benediktibk/electronics-library/3d-models/TS04-66-73-BK-100-SMT.stp

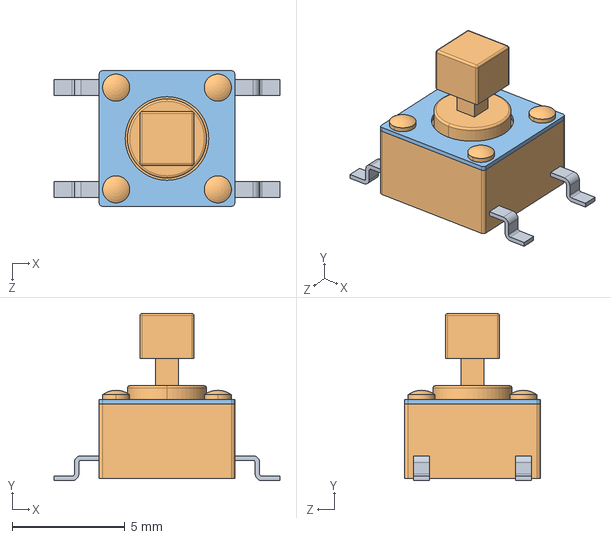
[picture p1: CAD file, 2025-07-14]
3d-models/TS04-66-73-BK-100-SMT.stp
10.0 x 7.40 x 6.00 mm
