benediktibk/electronics-library/3d-models/AT24C512C-SSHM-T.stp

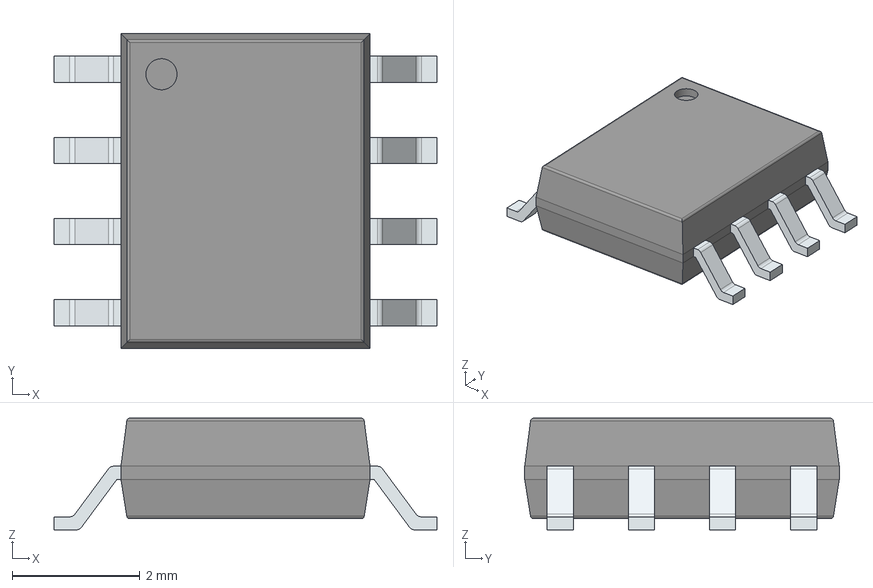
[picture p2: CAD file, 2025-07-14]
3d-models/AT24C512C-SSHM-T.stp
6.00 x 4.92 x 1.75 mm
PinsArrayLR
