benediktibk/electronics-library/3d-models/SRN2012T-6R8K.stp

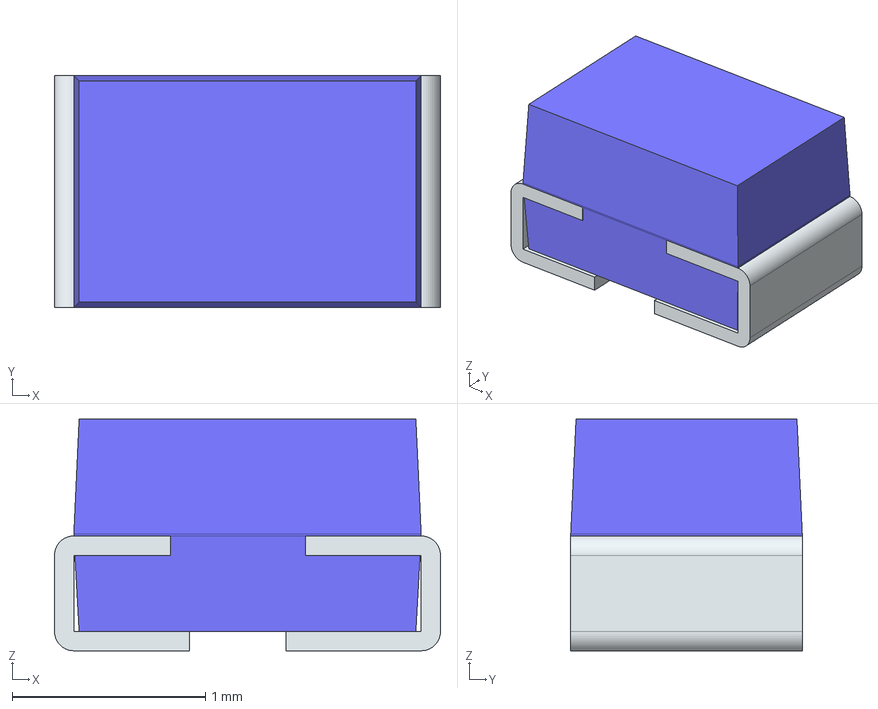
[picture p3: CAD file, 2025-07-11]
3d-models/SRN2012T-6R8K.stp
2.00 x 1.20 x 1.20 mm
FilletPin1
FilletPin2
