benediktibk/electronics-library/3d-models/LAN8720A-CP-ABC.stp

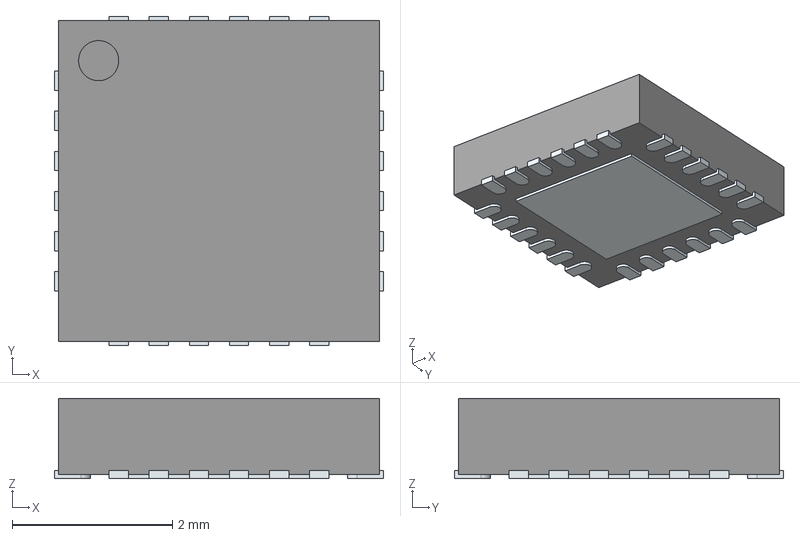
[picture p4: CAD file, 2025-07-11]
3d-models/LAN8720A-CP-ABC.stp
4.10 x 4.10 x 1.00 mm
ThermalPin
PinsArrayLR
PinsArrayTB
