benediktibk/electronics-library/3d-models/SDR0503-102KL.stp

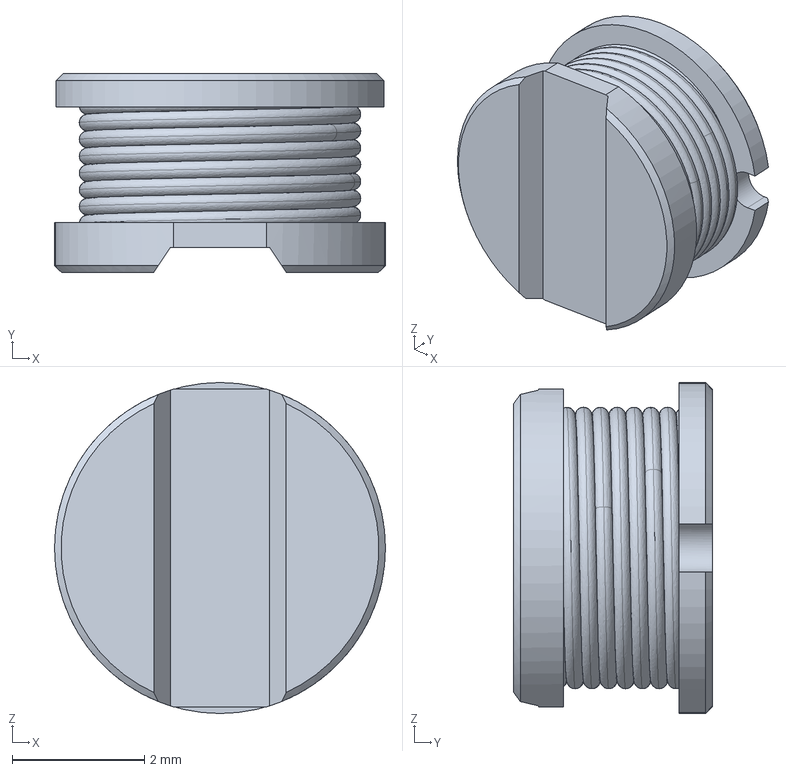
[picture p5: CAD file, 2025-07-11]
3d-models/SDR0503-102KL.stp
5.00 x 3.00 x 5.00 mm
