benediktibk/electronics-library/3d-models/B280-13-F.stp

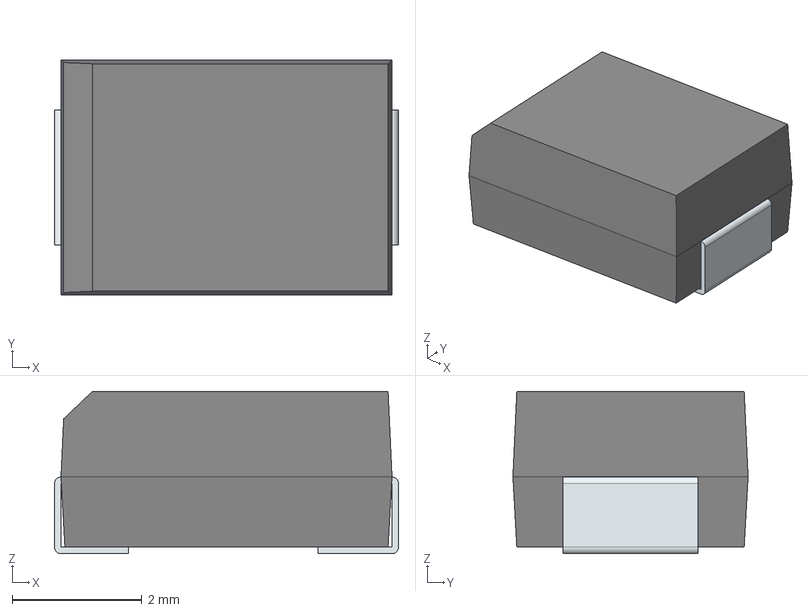
[picture p6: CAD file, 2025-07-11]
3d-models/B280-13-F.stp
5.29 x 3.62 x 2.50 mm
FilletPin1
FilletPin2
