benediktibk/electronics-library/3d-models/LV2862XLVDDCR.stp

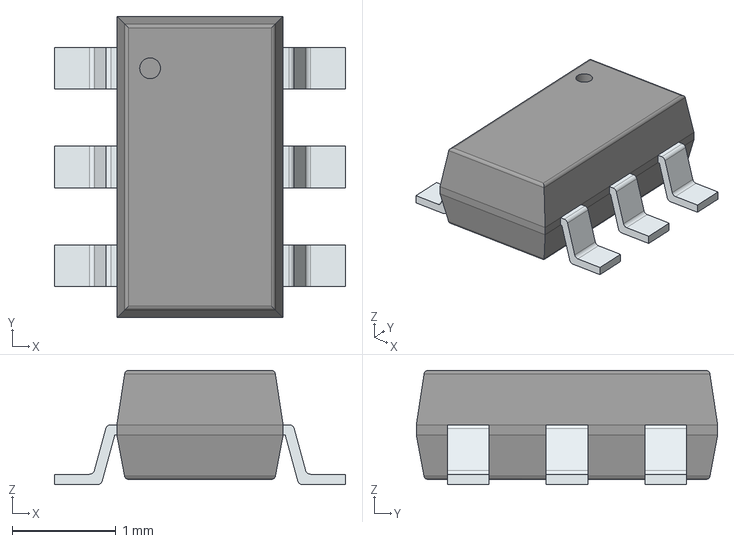
[picture p7: CAD file, 2025-07-11]
3d-models/LV2862XLVDDCR.stp
2.80 x 2.90 x 1.10 mm
PinsArrayLR
