benediktibk/electronics-library/3d-models/SMAJ58A.stp

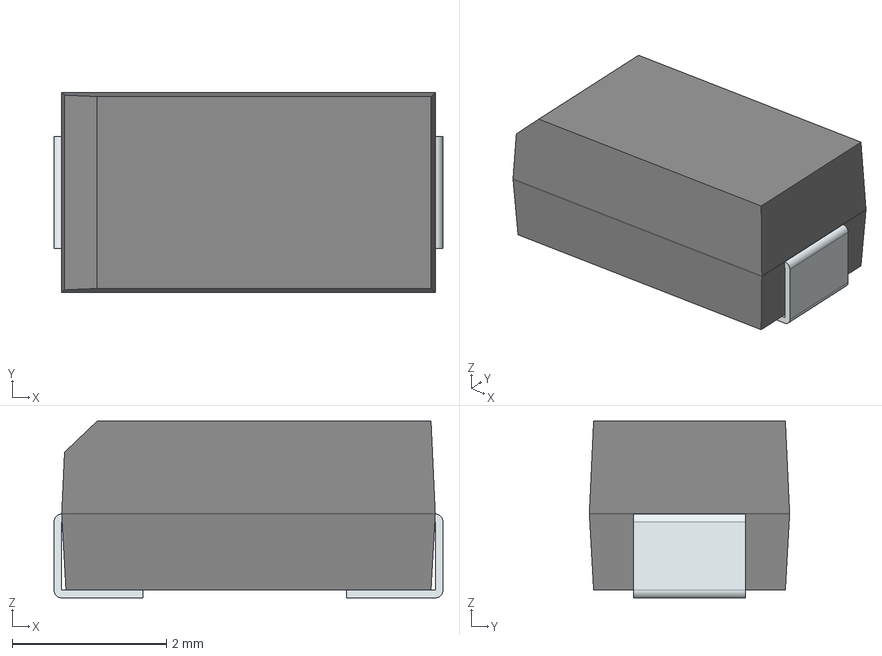
[picture p8: CAD file, 2025-07-11]
3d-models/SMAJ58A.stp
5.04 x 2.60 x 2.29 mm
FilletPin1
FilletPin2
