benediktibk/electronics-library/3d-models/MAX5969BETB+T.stp

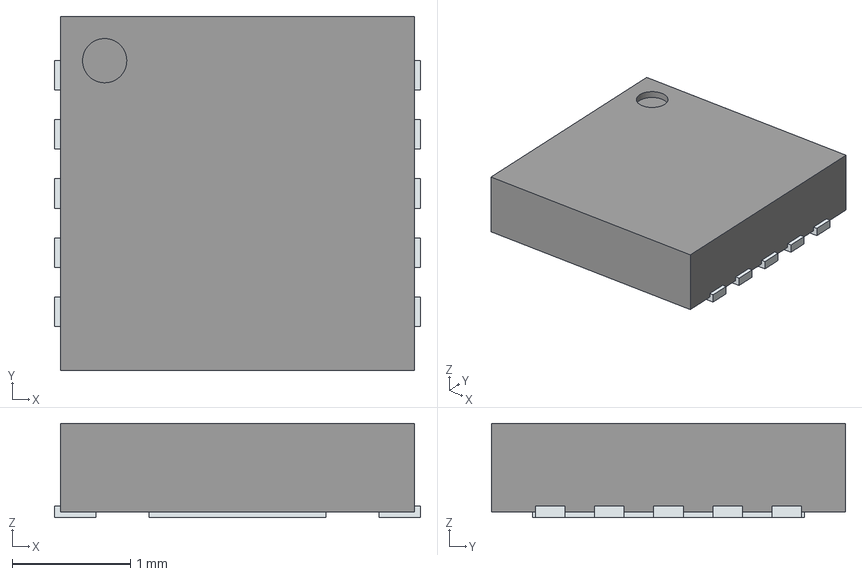
[picture p9: CAD file, 2025-07-11]
3d-models/MAX5969BETB+T.stp
3.10 x 3.00 x 0.8 mm
ThermalPin
PinsArrayLR
