benediktibk/electronics-library/3d-models/ABS8.stp

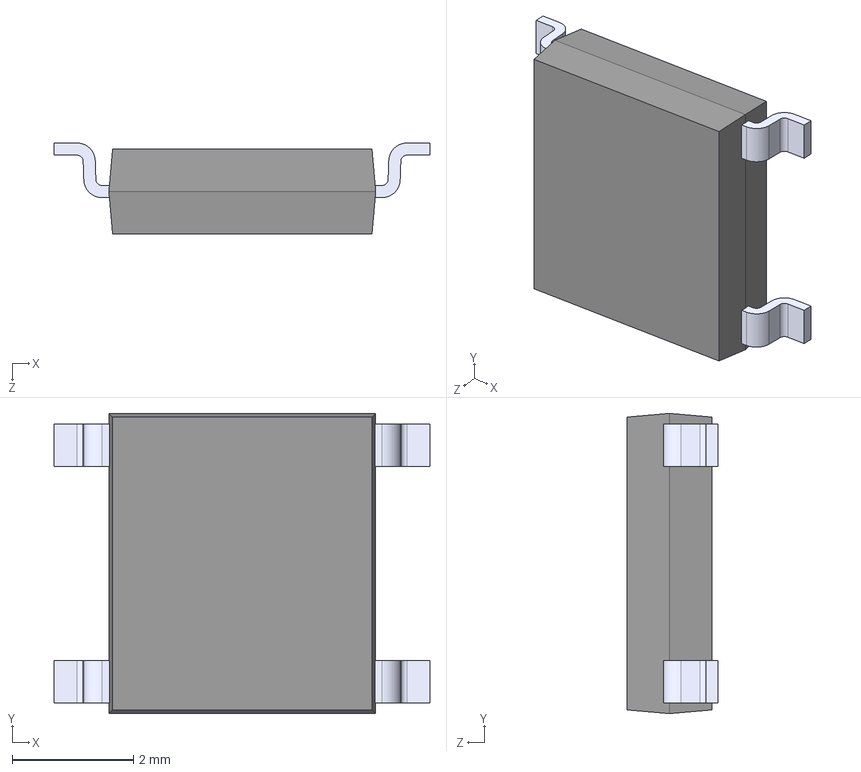
[picture p10: CAD file, 2025-07-09]
3d-models/ABS8.stp
6.20 x 4.95 x 1.50 mm
034001-05000-body
034001-05000-body_2
034001-05000-body_4
034001-05000-body_3
034001-05000-body_1
