benediktibk/electronics-library/3d-models/CX2016FB25000C0FZZH1.stp

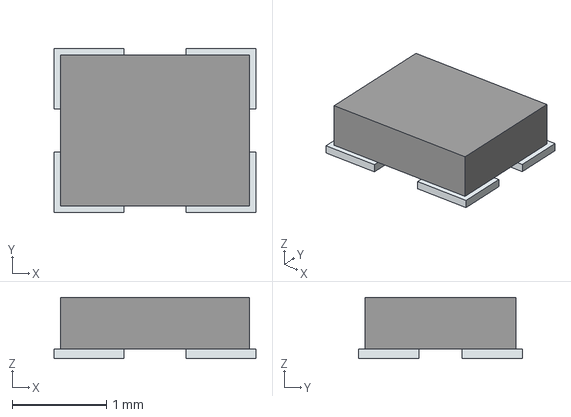
[picture p11: CAD file, 2025-07-08]
3d-models/CX2016FB25000C0FZZH1.stp
2.14 x 1.74 x 0.65 mm
Pins
