benediktibk/electronics-library/3d-models/PM8803TR.stp

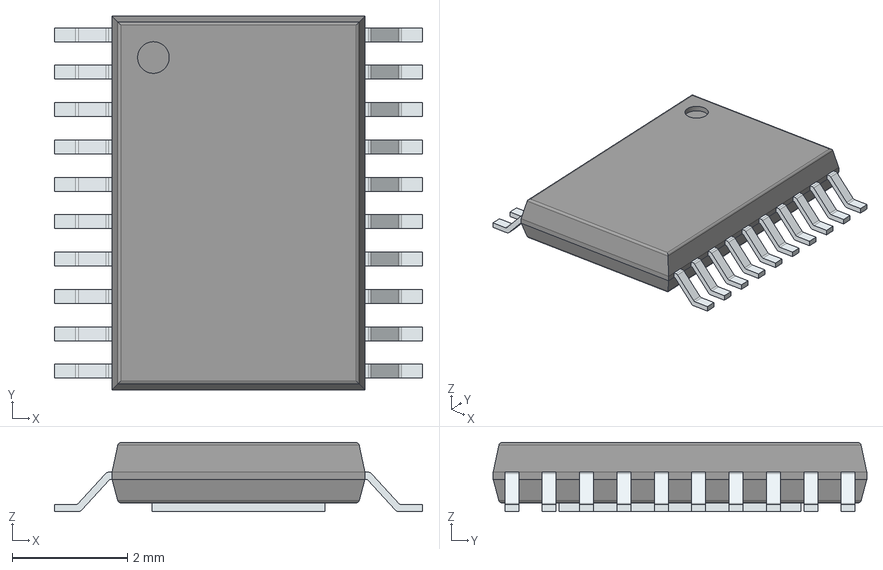
[picture p12: CAD file, 2025-03-16]
3d-models/PM8803TR.stp
6.40 x 6.50 x 1.20 mm
PinsArrayLR
ThermalPad
