benediktibk/electronics-library/3d-models/RLB0914-220KL.stp

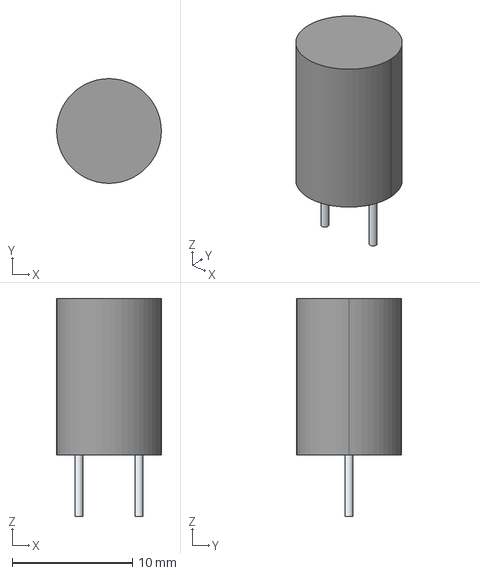
[picture p13: CAD file, 2025-03-11]
3d-models/RLB0914-220KL.stp
8.70 x 8.70 x 18.1 mm
Leads
