benediktibk/electronics-library/3d-models/TS02-66-50-BK-100-SCR-D.stp

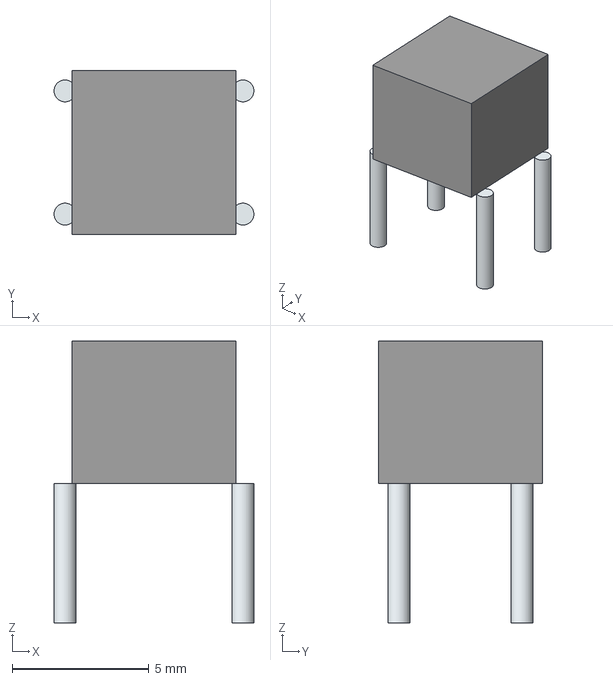
[picture p14: CAD file, 2025-03-10]
3d-models/TS02-66-50-BK-100-SCR-D.stp
7.30 x 6.00 x 10.3 mm
Leads
