benediktibk/electronics-library/3d-models/HSB06-181810.stp

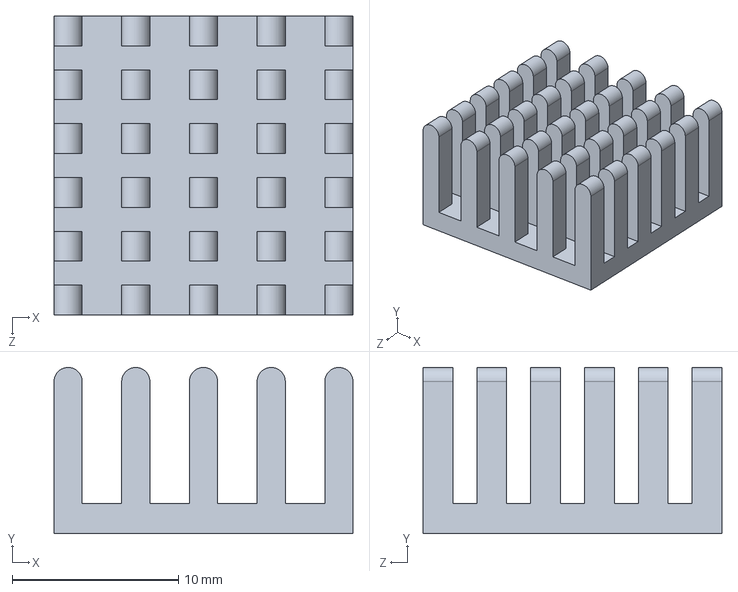
[picture p15: CAD file, 2025-01-08]
3d-models/HSB06-181810.stp
18.0 x 10.0 x 18.0 mm
