benediktibk/electronics-library/3d-models/HSB43-454515P.stp

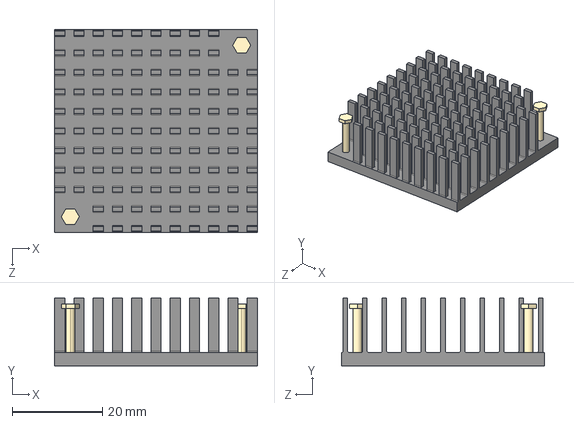
[picture p16: CAD file, 2025-01-06]
3d-models/HSB43-454515P.stp
45.0 x 15.0 x 45.0 mm
