benediktibk/electronics-library/3d-models/LM5122MHX_NOPB.stp

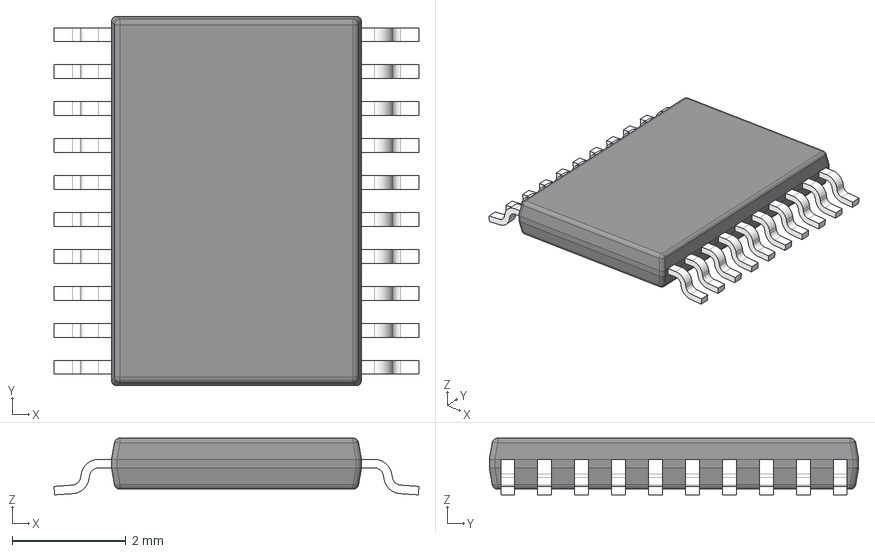
[picture p17: CAD file, 2025-01-01]
3d-models/LM5122MHX_NOPB.stp
6.42 x 6.50 x 1.00 mm
BODY-SO
LEAD-SO x 20
THERMALPAD-SO
PIN1-ID
