benediktibk/electronics-library/3d-models/phoenix_contact_1881626.stp

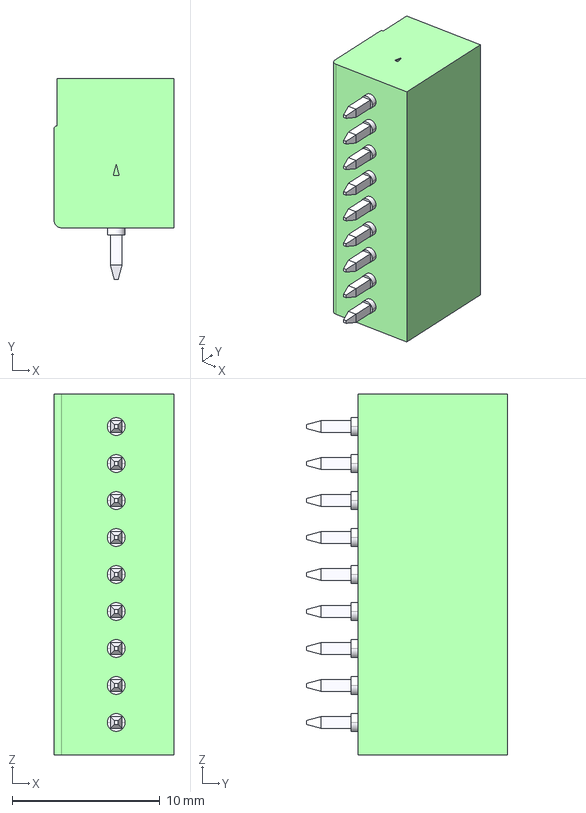
[picture p18: CAD file, 2024-12-29]
3d-models/phoenix_contact_1881626.stp
8.10 x 13.6 x 24.4 mm
