benediktibk/electronics-library/3d-models/LT8584EFE#PBF.stp

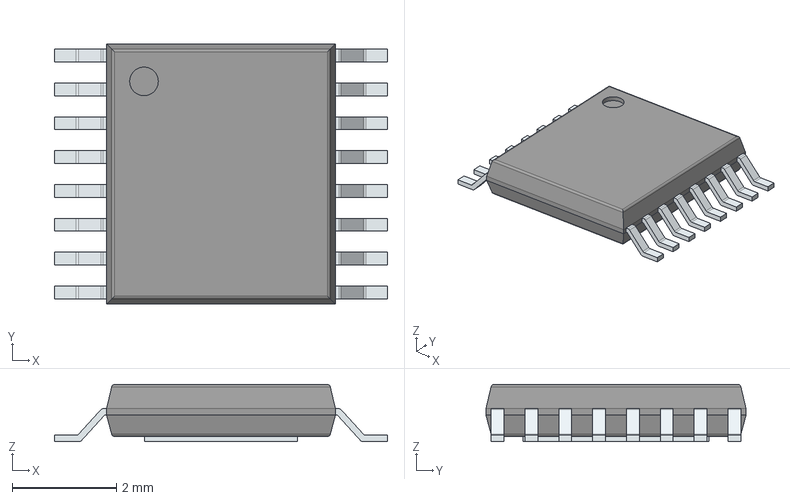
[picture p19: CAD file, 2024-06-02]
3d-models/LT8584EFE#PBF.stp
6.40 x 5.00 x 1.10 mm
PinsArrayLR
ThermalPad
