benediktibk/electronics-library/3d-models/NA6252-ALD.stp

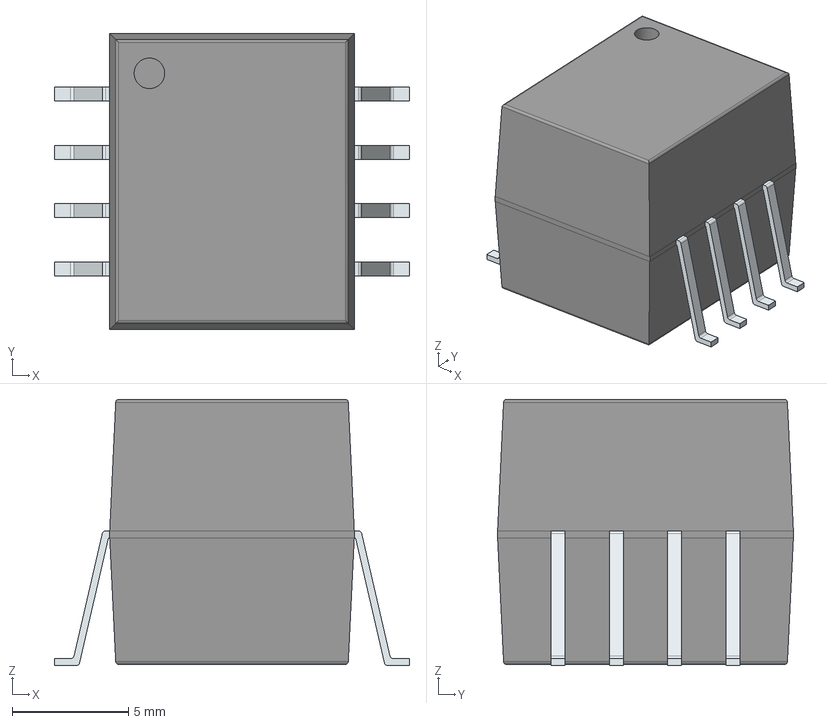
[picture p20: CAD file, 2024-06-02]
3d-models/NA6252-ALD.stp
15.2 x 12.7 x 11.4 mm
PinsArrayLR
