benediktibk/electronics-library/3d-models/DPAK_2DP-T1-GE3_VIS.step

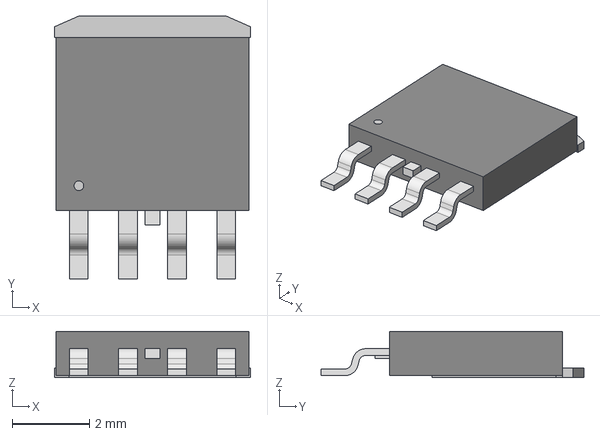
[picture p21: CAD file, 2024-06-01]
3d-models/DPAK_2DP-T1-GE3_VIS.step
5.08 x 6.81 x 1.20 mm
