benediktibk/electronics-library/3d-models/phoenix_1755736.stp

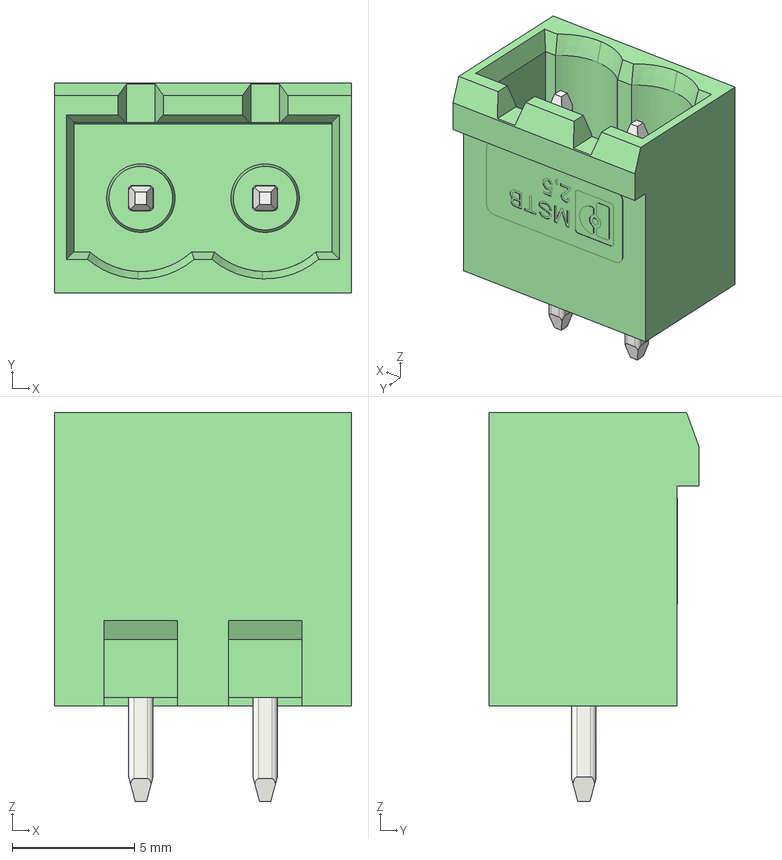
[picture p22: CAD file, 2024-06-01]
3d-models/phoenix_1755736.stp
12.2 x 8.57 x 15.9 mm
