benediktibk/electronics-library/3d-models/PowerPAK_SO-8L_SINGLE.STEP

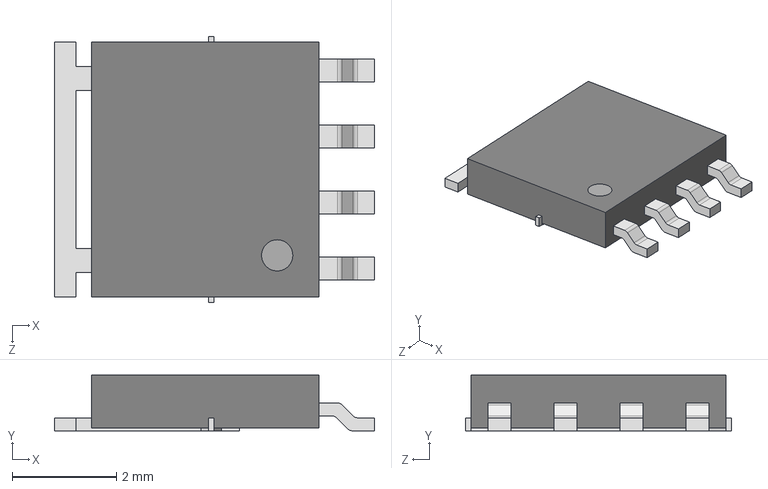
[picture p23: CAD file, 2024-05-31]
3d-models/PowerPAK_SO-8L_SINGLE.STEP
6.15 x 1.07 x 5.12 mm
Part_PowerPAK_SO-8L_По умолчанию
leg_PowerPAK_SO-8L_По умолчанию x 6
