benediktibk/electronics-library/3d-models/PCAP_16x16_5-ELECT_NCA.step

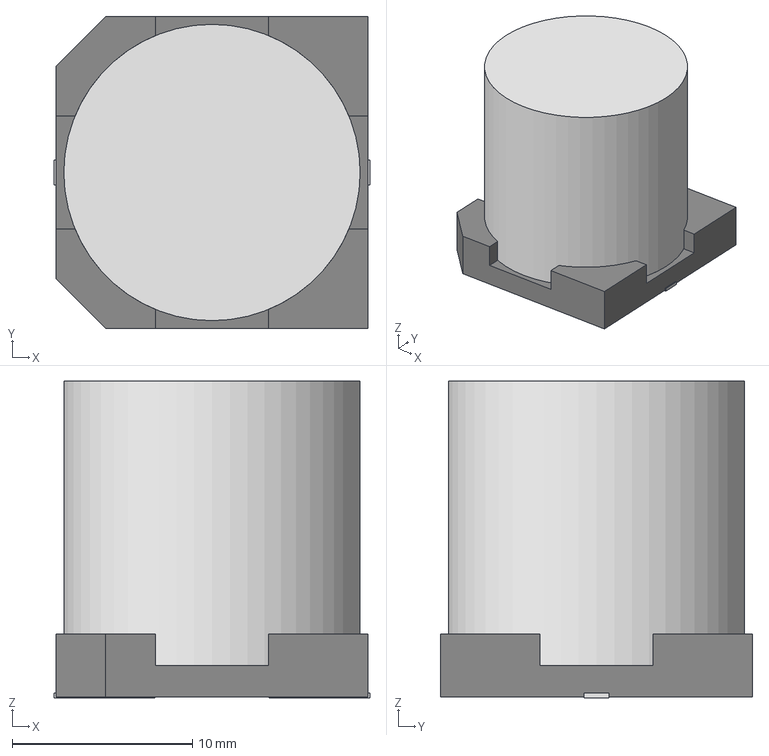
[picture p24: CAD file, 2024-05-31]
3d-models/PCAP_16x16_5-ELECT_NCA.step
17.5 x 17.3 x 17.6 mm
