benediktibk/electronics-library/3d-models/FTSH-105-01-F-DV-K.stp

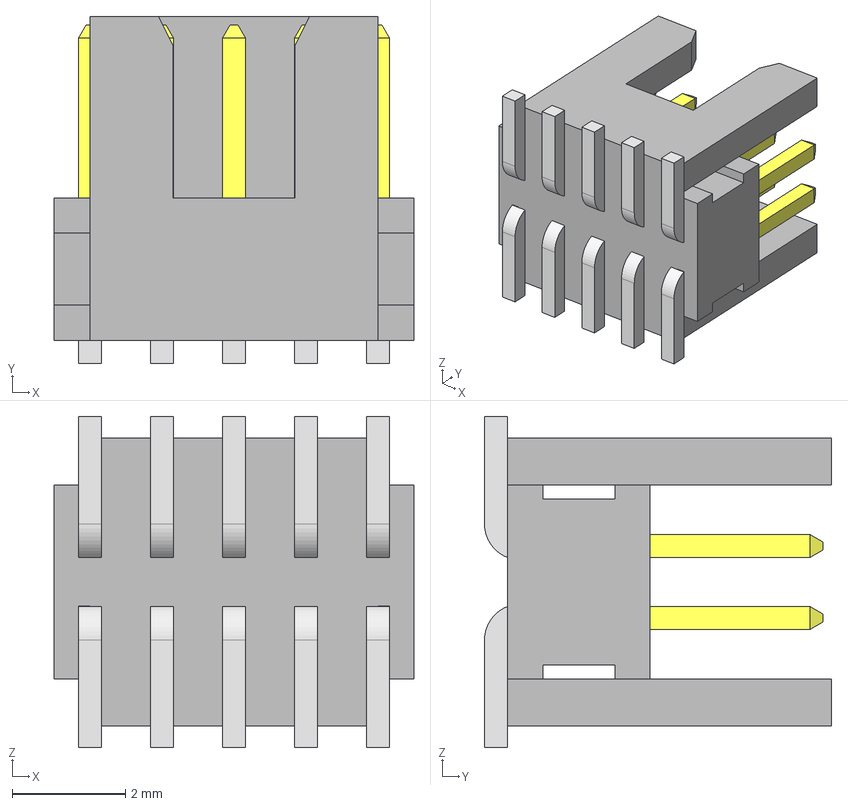
[picture p25: CAD file, 2024-04-06]
3d-models/FTSH-105-01-F-DV-K.stp
6.35 x 6.12 x 5.84 mm
FTSH-105-01-F-DV-K_body
FTSH-105-01-F-DV-K_pins1
FTSH-105-01-F-DV-K_pins2
