benediktibk/electronics-library/3d-models/LM5176PWPR.stp

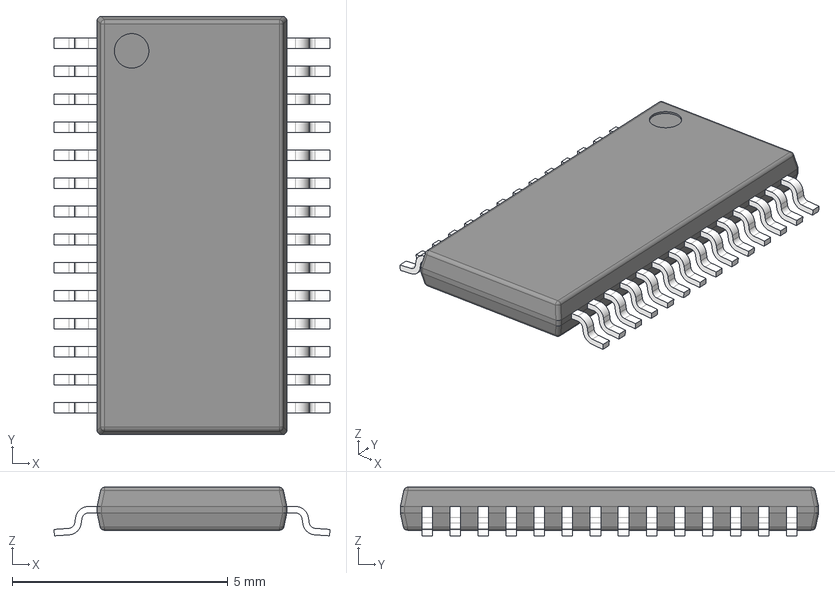
[picture p26: CAD file, 2024-02-21]
3d-models/LM5176PWPR.stp
6.40 x 9.70 x 1.13 mm
BODY-TSSOP
LEAD-TSSOP x 28
PIN1
DAP
