benediktibk/electronics-library/3d-models/ETQ-P8M2R5JFA.stp

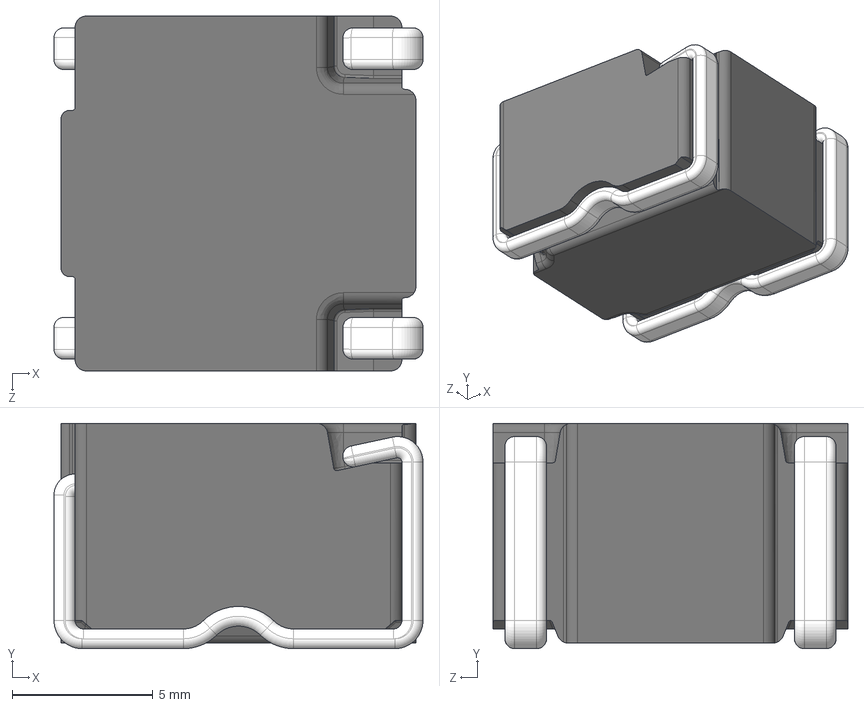
[picture p27: CAD file, 2024-02-21]
3d-models/ETQ-P8M2R5JFA.stp
13.1 x 8.00 x 12.6 mm
MC_3R3
LEAD_3R3_
