benediktibk/electronics-library/3d-models/SIL05-1A72-BV669.stp

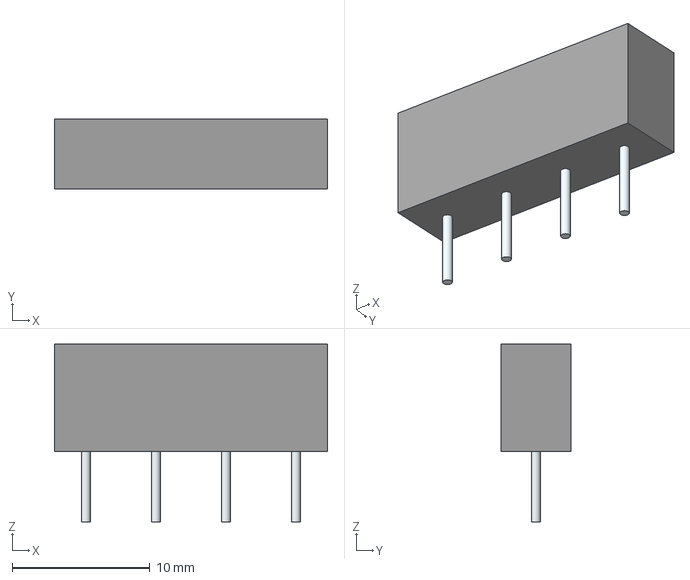
[picture p28: CAD file, 2023-12-03]
3d-models/SIL05-1A72-BV669.stp
19.8 x 5.08 x 12.9 mm
Leads
