benediktibk/electronics-library/(list of files, cad)

Other CAD files:
3d-models/1149611.stp
3d-models/219320-0001.stp
3d-models/7443640330_WE-HCF-2818_rev1.stp
3d-models/MAL219690101E3.stp
3d-models/PT61018PEL.stp
3d-models/SM13126PEL.stp
3d-models/SM51625EL.stp
