benediktibk/electronics-library/(commit log)

2023-08-13 add USB and debug connectors
2023-10-15 add charge and discharge FETs
2023-10-18 add N-MOSFET and schottky diode
2023-10-20 add BOM script with RS order numbers
2023-10-21 add footprints
2023-10-21 add micro USB connector
2023-10-21 add resistors
2023-10-21 add capacitors and inductance
2023-10-21 add 47uF SMD capacity
2023-10-21 add M6 connector
2023-10-21 add missing resistor footprint
2023-11-12 add capacitors and resistors
2023-11-13 add resistors, capacitors and LEDs
2023-11-19 add devices
2023-11-23 add blade fuse holder
2023-11-25 add charge pump
2023-11-25 fix pin types
2023-11-25 fix pin tables
2023-11-25 update footprints
2023-11-30 use own mounting hole footprint
2023-12-01 improve silkscreens
2023-12-02 add solder wire pad
2023-12-02 add 3D Model of supercap
    [MAL219690101E3.stp]
2023-12-03 add 3D models of reed relais and update footprint of super capacitor
    [SIL05-1A72-BV669.stp]
2023-12-04 group components in BOM by order number
2024-02-21 add footprint for 2.5uH
    [ETQ-P8M2R5JFA.stp]
2024-02-21 add missing footprints and 3D models
    [LM5176PWPR.stp]
2024-04-06 add connectors with 5.08 mm pitch
2024-04-06 fix footrpint of SWD connector
    [FTSH-105-01-F-DV-K.stp]
2024-04-06 add heatsink
2024-04-07 fix footprint of TMG1-01
2024-05-30 fix footprint for inductor
2024-05-31 add 3D models
    [PCAP_16x16_5-ELECT_NCA.step, PowerPAK_SO-8L_SINGLE.STEP]
2024-06-01 add new NMOS
    [DPAK_2DP-T1-GE3_VIS.step]
2024-06-02 add flyback transformer
    [NA6252-ALD.stp]
2024-06-02 add LT8584
    [LT8584EFE#PBF.stp]
2024-12-29 add components for temperature sensor in home-automation
    [phoenix_contact_1881626.stp]
2025-01-01 add parts
    [LM5122MHX_NOPB.stp]
2025-01-06 add components
    [HSB43-454515P.stp]
2025-01-06 improve footprints
2025-01-06 fix paths to 3d models
    [7443640330_WE-HCF-2818_rev1.stp]
2025-01-06 fix size of heatsink pad
2025-01-08 add other type of heatsinks
    [HSB06-181810.stp]
2025-03-04 remove BOM script
2025-03-10 add missing part numbers
    [TS02-66-50-BK-100-SCR-D.stp]
2025-03-11 add new inductance
    [RLB0914-220KL.stp]
2025-07-09 add component
    [ABS8.stp]
2025-07-14 fix footprint of AT24C512C
    [AT24C512C-SSHM-T.stp]
2025-07-14 add SMD switch
    [TS04-66-73-BK-100-SMT.stp]
2025-07-15 fix footprint
