benediktibk/electronics-library/(notices)

Notices in the files:
3d-models/FTSH-105-01-F-DV-K.stp:
author */ ('License CC BY-ND 4.0'),
